Mohamedashrafzamzam/Robotics_Drawing_project_group_21/Drawing1.jpeg

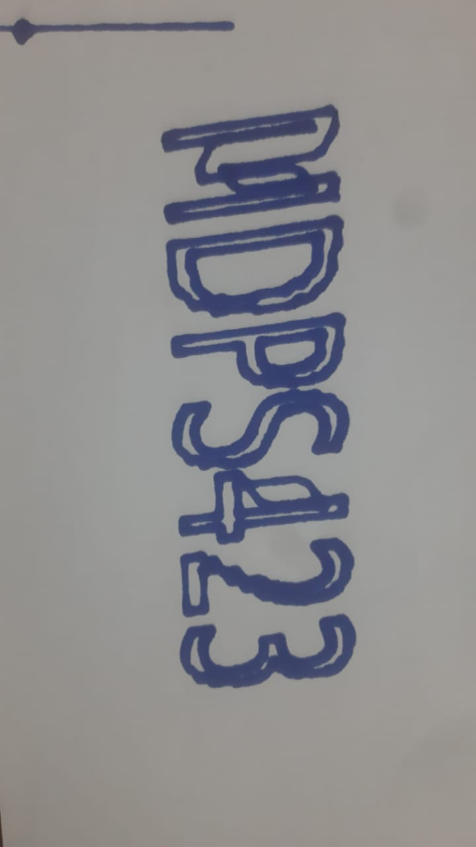
Drawing1.jpeg
