Mohamedashrafzamzam/Robotics_Drawing_project_group_21/Screenshot from 2025-12-22 20-11-38.png

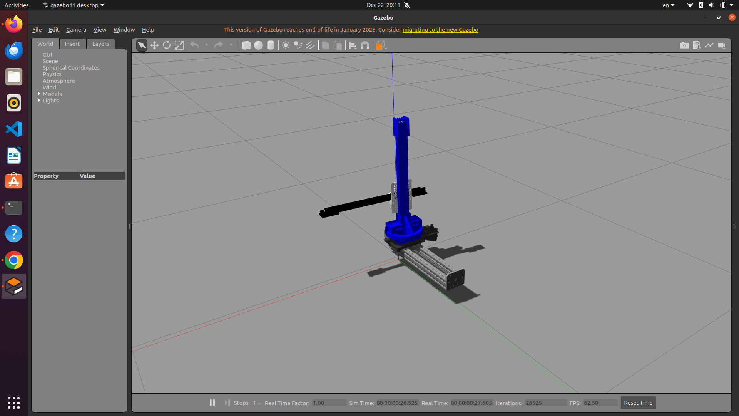
Screenshot from 2025-12-22 20-11-38.png
