Mohamedashrafzamzam/Robotics_Drawing_project_group_21/Screenshot from 2025-12-23 04-14-08.png

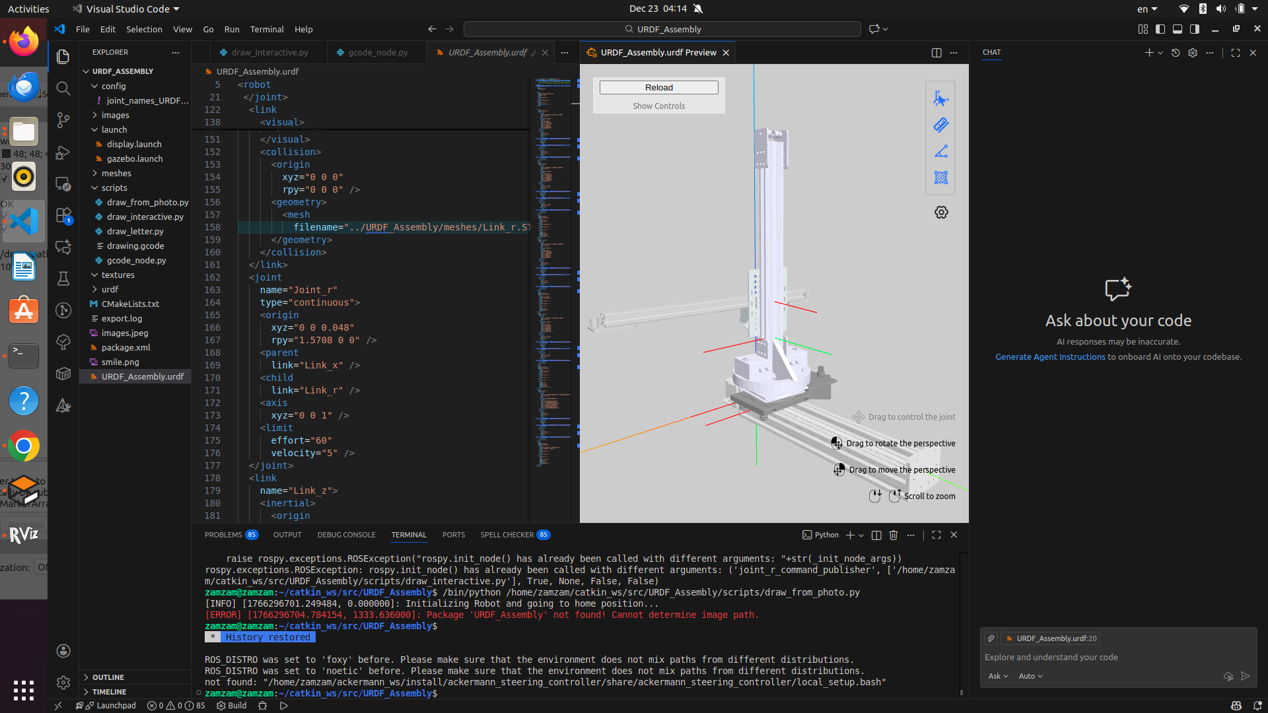
Screenshot from 2025-12-23 04-14-08.png
