Mohamedashrafzamzam/Robotics_Drawing_project_group_21/Screenshot from 2026-04-23 23-39-06.png

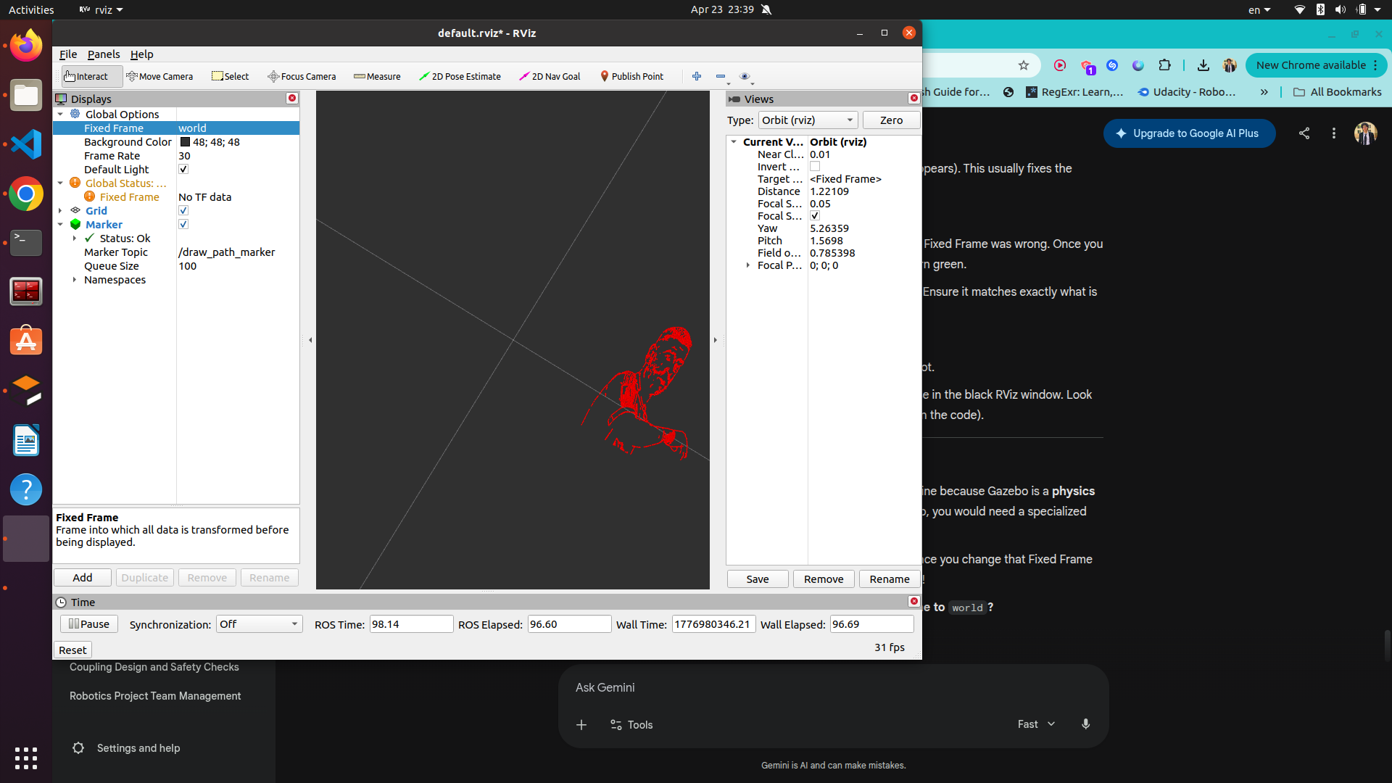
Screenshot from 2026-04-23 23-39-06.png
