Mohamedashrafzamzam/Robotics_Drawing_project_group_21/WhatsApp Image 2025-12-22 at 8.27.56 PM.jpeg

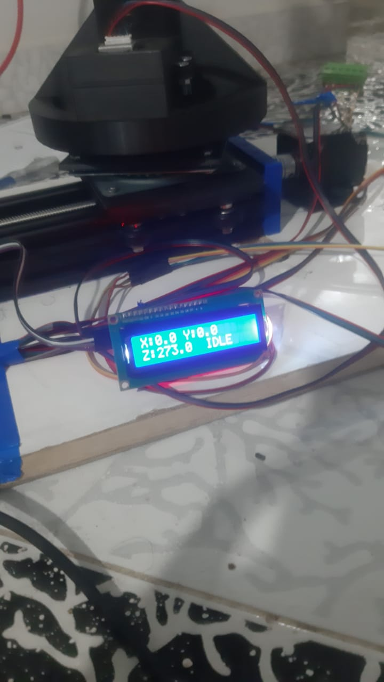
WhatsApp Image 2025-12-22 at 8.27.56 PM.jpeg
