Mohamedashrafzamzam/Robotics_Drawing_project_group_21/WhatsApp Image 2025-12-23 at 2.03.57 AM.jpeg

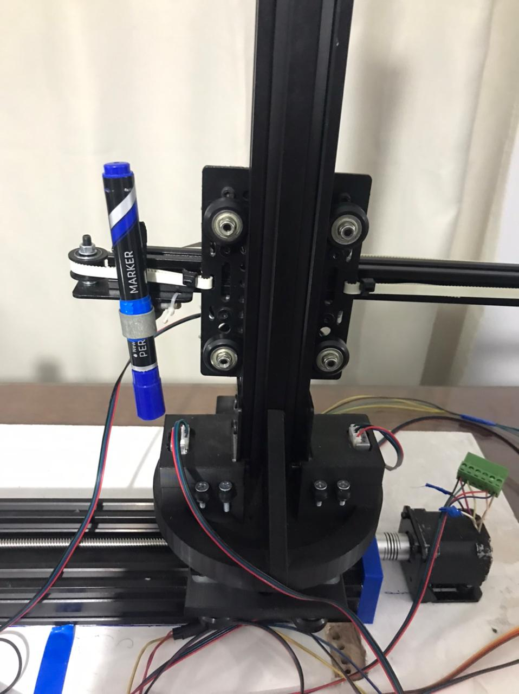
WhatsApp Image 2025-12-23 at 2.03.57 AM.jpeg
