Mohamedashrafzamzam/Robotics_Drawing_project_group_21/catkin_ws/src/URDF_Assembly/images.jpeg

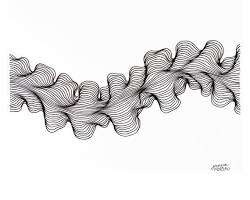
catkin_ws/src/URDF_Assembly/images.jpeg
