Mohamedashrafzamzam/Robotics_Drawing_project_group_21/catkin_ws/src/URDF_Assembly/smile.png

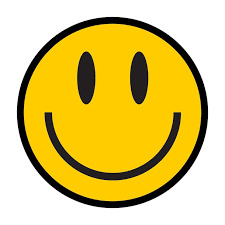
catkin_ws/src/URDF_Assembly/smile.png
